richsanj0-commits/APEX-LFR-STMG-Series/(commit log)

2026-09-18 Initial commit: STM32G431CB line follower (14-channel multiplexed PID system and 8-sensor test bench)
2026-09-19 feat(sensor_8array): add PB5 forward and PB4 backward wheel controls with live binary display
2026-09-19 fix(sensor_8array): simplify code to original 8-sensor test with PB5 forward and PB4 backward
    [main.cpp]
2026-09-19 fix(motors): invert right motor polarity so both wheels rotate forward on PB5 and backward on PB4
    [main.cpp]
2026-09-19 docs: document PB5 forward and PB4 backward wheel test controls in README
2026-09-19 feat(sensor_8array): adopt new robust non-blocking bench setup with aligned wheel directions and live telemetry
2026-09-19 feat(lfr): complete 8-IR autonomous PID line follower firmware with corner braking and recovery
2026-09-19 feat(lfr): adapted user LF-2 template with reduced speed, PC13 calibrate, PB5 start, PB3 reset
    [main.cpp]
2026-09-19 tune(lfr): increase speed to 110, increase Kp to 0.080, and double calibration time to 8 seconds
2026-09-19 fix(sensors): correct mapping so 1 is black line and 0 is white floor
    [main.cpp]
2026-09-19 fix(sensors): map low ADC to 1 (Black Line) and high ADC to 0 (White Floor), add idle live preview and PB4 jog
    [main.cpp]
2026-09-19 fix(sensors): reverse sensor pin order to {PA7..PA0} so S0 is left-most and S7 is right-most
    [main.cpp]
2026-09-19 fix(sensors): inverse black/white logic back to (0..1000)
    [main.cpp]
2026-09-19 tune(pid): restore baseline Kp=0.030 and Kd=0.200 for smooth line tracking
2026-09-19 feat(menu): interactive OLED menu for tuning Speed (+/-5), Kp (+/-0.01), Kd (+/-0.1), Calibrate and Run with 4 buttons
2026-09-19 fix(display): use String(val,3) and enable _printf_float so Kp and Kd display clearly on OLED
    [main.cpp]
2026-10-08 feat: analog mm-position firmware, 14-sensor bench diagnostics and findings
    - apex_lfr: new firmware with fast ADC (3 us/read), correct MUX order
    (I7 skipped), calibrated analog line position in mm with 25% noise
    floor, fixed 1 kHz PID, same 4-button OLED menu
    - sensor_14array_test: serial diagnostics (raw stream, noise/settle
    test, calibration dump, position stream, hand calibration)
    - line_follower_mux14: fix MUX mapping (skip unconnected I7); invert
    right motor direction
    - hardware: sensor board Gerbers + pad/net extraction script
    - bench_data: white/black, noise, settle and slide recordings
    - docs/BENCH_FINDINGS.md: layout, levels, D1/D9 fault, ADC timing,
    filter design and gai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
    [LineFollower-B_Cu.gbr, LineFollower-B_Mask.gbr, LineFollower-B_Paste.gbr, LineFollower-B_Silkscreen.gbr, LineFollower-Edge_Cuts.gbr, LineFollower-F_Cu.gbr, LineFollower-F_Mask.gbr, LineFollower-F_Paste.gbr]
2026-10-08 feat(apex_lfr): all 14 sensors, line segment selection, auto line colour
    - Re-enable S0/S8 after re-soldering pull-ups RD1/RD9 (ranges 3441/3320)
    - Split sensor readings into line segments and follow one instead of
    averaging onto the white between them; default NEAREST keeps straight
    through 3-way splits (serial 'b' cycles NEAREST/LEFT/RIGHT)
    - Auto-detect white line on black background with hysteresis; solid
    black areas do not trigger a switch (serial 'w' AUTO/BLACK/WHITE)
    - Lower default gains to Kp 3.5 / Kd 30 after overshoot on track
    - Docs: repair results, wheels-up check, track findings
    [main.cpp]
