richsanj0-commits/APEX-LFR-STMG-Series/(notices)

Notices in the files:
README.md:
License: MIT
